Pezhgorski/duplo-inspection-cell/docs/images/spike_crops.jpg

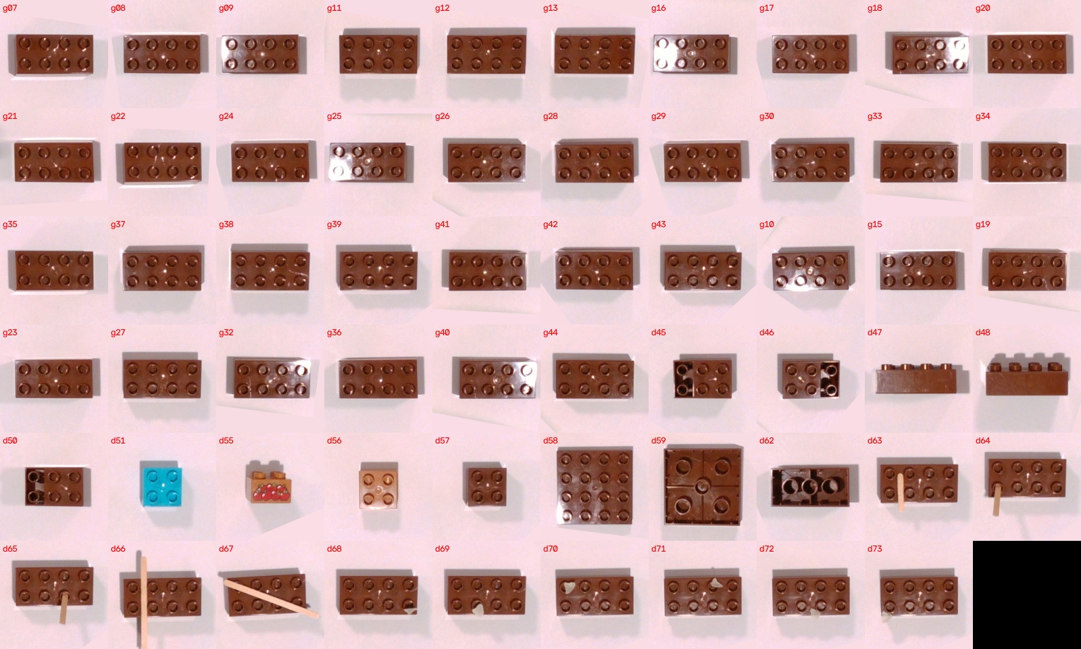
docs/images/spike_crops.jpg
