Pezhgorski/duplo-inspection-cell/docs/images/spike_heatmaps_all.jpg

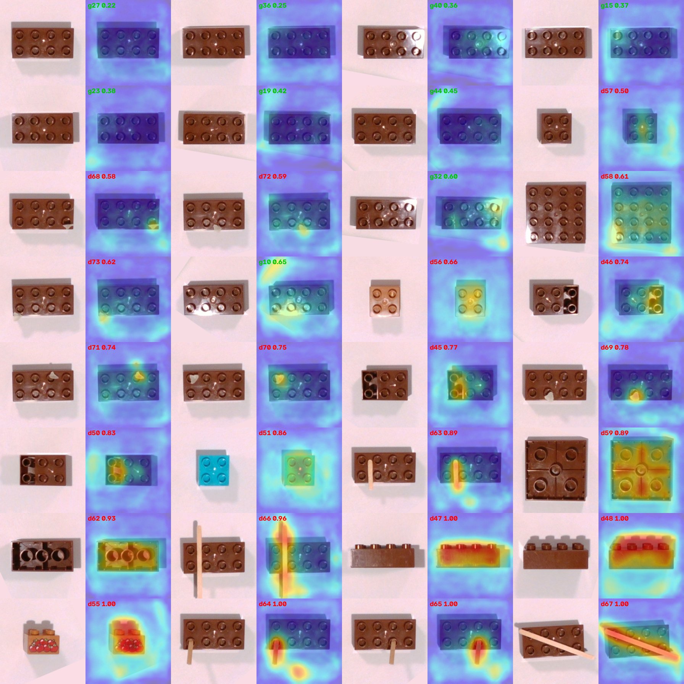
docs/images/spike_heatmaps_all.jpg
