Pezhgorski/duplo-inspection-cell/(commit log)

2026-10-11 Duplo inspection cell: machine vision + AI demo
    RealSense D435 capture with locked exposure/white balance, part localisation
    and alignment inside a fitted plate box, size rule + PatchCore anomaly
    detection, live inspection with heatmap, and an Arduino-driven stepper arm.
    Includes the Bulgarian write-up, design spec and spike findings.
2026-10-12 Modbus RTU reject handshake: slave firmware, master, auto-reject, tests
    - firmware/reject_cell: the Mega as a Modbus RTU slave (spec §7). Non-blocking
    strike via AccelStepper, slave heartbeat, 1 s master watchdog that halts the
    motor, move timeout, edge-armed REQ_REJECT / RESET_FAULT, return home after a
    reset. The logic lives in RejectController with no Arduino dependencies.
    - cell/actuator.py: pymodbus master with the 4-way handshake, BUSY/DONE/release
    timeouts, slave heartbeat check, cycle-count cross-check, auto-reset of a
    leftover COMM_LOST on connect, and resending of writes whose replies are lost.
    ActuatorThread runs it beside the camera loop.
    - cell/reject.py: strike a s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
    [RejectController.cpp, RejectController.h, actuator.py, fake_arm.h, reject.py, reject_cell.ino, reject_controller_test.cpp]
2026-10-12 Threshold with empty val scores; report oversized blobs as too_large
    - choose_threshold moves to cell/threshold.py and no longer crashes when val
    has no surface defects (every defect caught by the size rule) or no good
    bricks: the side that exists sets the bound, anomalib's 0.5 fills in for the
    missing one. meta.json gains threshold_basis; separable is kept.
    - find_part reports a blob bigger than MAX_AREA (a hand, the arm) as
    "too_large" instead of "outside", so the HMI no longer says
    "PART NOT FULLY INSIDE" for a hand fully inside the box.
    - tests: threshold cases, and part search / alignment on synthetic images.
    Claude-Sess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
    [geometry.py, test_geometry.py, test_threshold.py, threshold.py]
2026-10-12 Firmware tests: build with MSVC (via vswhere/vcvars64) when g++ is missing
    [test_firmware.py]
2026-10-12 Hold the strike while a hand is in the plate box; re-arm only after 3 empty frames
2026-10-12 Actuator: latch ACTUATOR_INTERNAL on bugs, require a fresh status, auto-recover a stall's COMM_LOST
    [actuator.py, test_actuator.py, test_firmware.py]
2026-10-12 inspect_test: finish a running strike before quitting; start the arm after the camera
2026-10-12 Actuator: re-send the strike settings after a fault reset and before every strike
    A Mega reboot during FAULT went NOT_HOME -> R -> IDLE without the
    settings being re-written, so the next strike used firmware defaults.
    reset()/confirm_home() now return whether a reset was queued, and
    internal_error() drops REQ_REJECT best-effort.
    [actuator.py, test_actuator.py, test_firmware.py]
2026-10-12 inspect_test: close the arm before the camera; say what X and R did
